UMONS-GFA/pihat/(commit log)

2017-11-17 add initial files
    [Ideal_Diode.sch, pihat_template.kicad_pcb, pihat_template.sch]
2017-11-17 add non connected flags
    [pihat_template.sch]
2017-11-17 add ground
    [pihat_template.sch]
2017-11-17 add power supply global label
    [pihat_template.sch]
2017-11-17 add PWR flag and fix electric check
    [Ideal_Diode.sch, pihat_template.sch]
2017-11-17 change resistors form factor to 0805
    [pihat_template.sch]
2017-11-17 change some resistors and capacitors form factor to 0805
    [Ideal_Diode.sch, pihat_template.sch]
2017-11-17 add new eeprom reference
    [pihat_template.sch]
2017-11-17 replaced r and c footprints with project:r_805 and project:c_805
    [Ideal_Diode.sch, pihat_template.sch]
2017-11-17 created DMMT5401 footprint and updated netlist
    [Ideal_Diode.sch, pihat_template.kicad_pcb]
2017-11-19 refactored pihat to include larger components, reorganize space around tiny components and let spaces along edges for further connectors, battery holder...
    [pihat_template.kicad_pcb]
2017-11-21 added GND and VPP on silk mask
    [pihat_template.kicad_pcb]
2017-11-21 Added components for serial, clock and 1-wire
    [Ideal_Diode.sch, pihat_template.sch]
2017-11-21 update scheme
    [pihat_template.sch]
2017-11-21 renamed files, fixed schema, addeed missing libs and mods, created pcb
    [Ideal_Diode.sch, pihat.kicad_pcb, pihat.sch]
2017-11-22 corrected label on a connector and bit of cleaning
    [pihat.kicad_pcb, pihat.sch]
2017-11-22 resize and rename global labels
    [pihat.sch]
