UMONS-GFA/pihat/(notices)

Notices in the files:
hardware/pihat_template.kicad_pcb:
License: CERN OHL V1.2
